MST-MRDT/DCDC-Buck-Converter/README.md

# DCDC-Buck-Converter
Repo for the hardware files for the DC/DC buck converter
