MST-MRDT/DCDC-Buck-Converter/dcdc_converter_sim.asc

C1: polcap; 22µ; V=80 Irms=.115 Rser=.55
C2: polcap; 220µ; V=100 Irms=2.14 Rser=.068
C3: cap; 22p; V=50 Rser=0.02
C4: cap; 1000p; V=100 Rser=.02
CB: cap; .1µ
CC1: cap; 470p; V=50
CC2: cap; 1n; V=50
CC3: cap; 2200p; V=16
CDRVCC: cap; 10µ; V=16
CIN1: polcap; 100µ; V=100 Irms=.647 Rser=.305
COUT: polcap; 220µ; V=100 Irms=2.14 Rser=.068
CSS: cap; .1µ; V=16
CVCC: cap; 1µ
D1: schottky; RB160M-30
DB: diode; RF05VA1S
L1: ind; 3.3µ; Ipk=70 Rser=.0011
LOAD: res; R=V(VRESISTOR)
M1: nmos; PSMN4R060YS
M2: nmos; PSMN4R060YS
R1: res; 113k; tol=1 pwr=.063
R2: res; 8.06k; tol=1 pwr=.063
RC1: res; 10k
RC2: res; 10k
RF: res; 10; tol=1 pwr=.063
RMAX: res; 30k; tol=1 pwr=.063
RSET: res; 12k
TARGET: res; R=V(VRESISTOR)
U1: LTC3703-5
V1: voltage; 12
V2: voltage; PWL file=load_pwl.txt
VCC: voltage; 5
VIN: voltage; 24; Rser=.0048
Named nets: 0, VRESISTOR, VOUT, VTARGET
.tran 0 3m
Sense Line
Battery pack simulation
Load simulation
Step load resistor through values in PWL file
Ideal power supply for comparison
