MST-MRDT/DCDC-Buck-Converter/DC-DC Buck Converter Rev1.brd

## EAGLE design DC-DC Buck Converter Rev1.brd (2018-02-13)

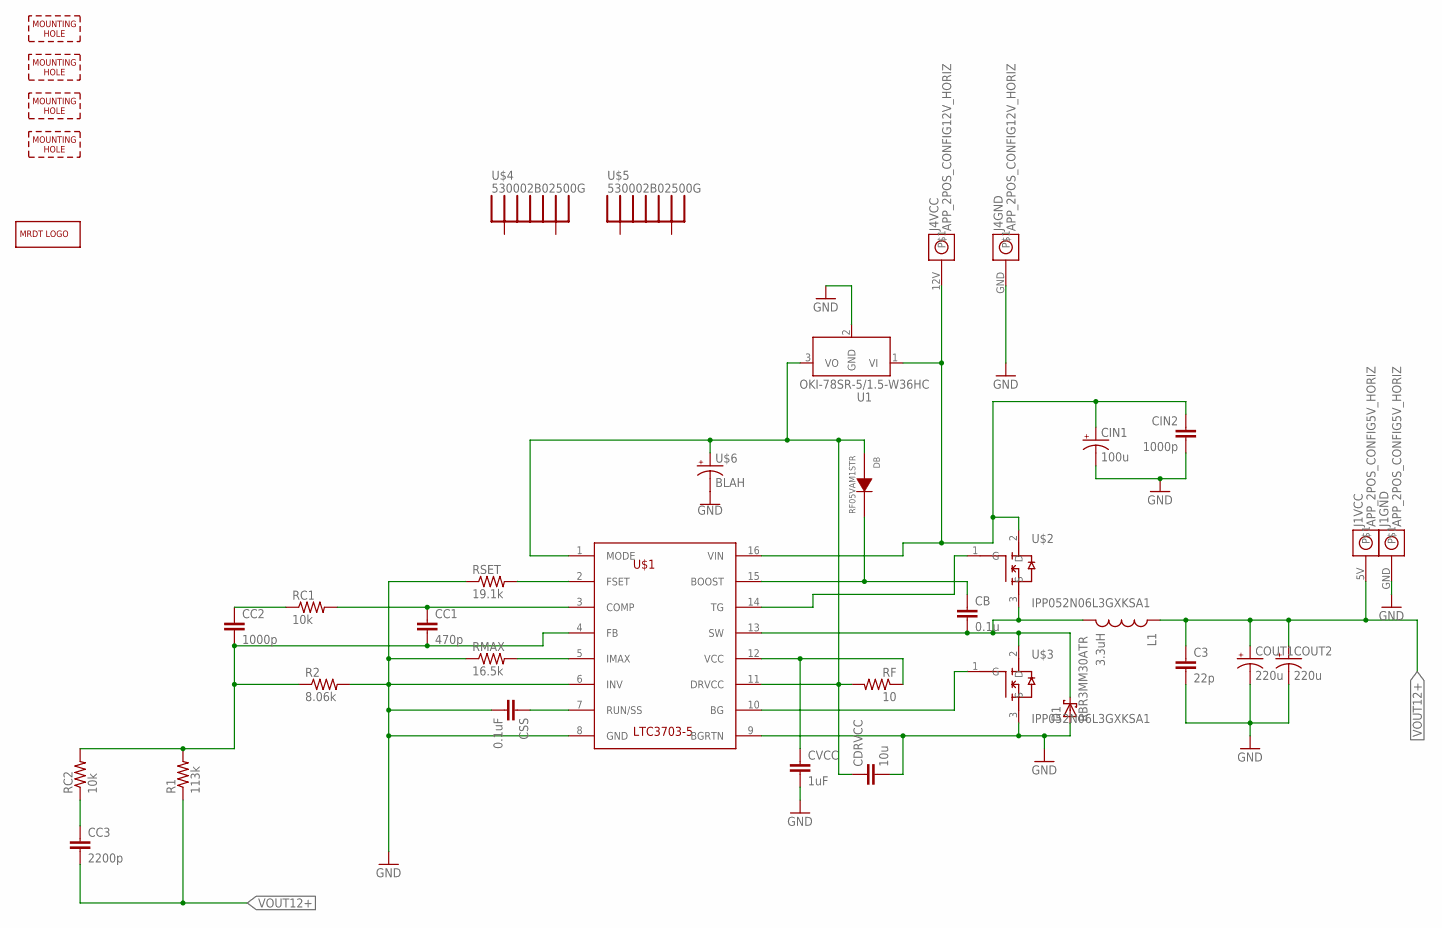
[picture p1: schematic DC-DC Buck Converter Rev1.sch]

Parts:
C3: 22p; 0603-CAP
CB: 0.1u; 0603-CAP
CC1: 470p; 0603-CAP
CC2: 1000p; 0603-CAP
CC3: 2200p; 0603-CAP
CDRVCC: 10u; 0603-CAP
CIN1: 100u; CAP_POL_220UF
CIN2: 1000p; 0603-CAP
COUT1, COUT2: 220u; CAP_POL_220UF
CSS: 0.1uF; 0603-CAP
CVCC: 1uF; 0603-CAP
D1: RBR3MM30ATR; DIODE_SCHOTTKY_30V_1A
DB: RF05VAM1STR; DIODE_STANDARD_100V
H1, H2, H3, H4: MOUNTING_HOLE#8; #8_SCREW
J1: APP_2POS_CONFIG5V_HORIZ; APP45_5V_HORIZ_CONFIG
J4: APP_2POS_CONFIG12V_HORIZ; APP45_12V_HORIZ_CONFIG
L1: 3.3uH; PLANAR_INDUCTOR_3.3UH
LOGO1: MRDT_LOGO
R1: 113k; 0603-RES
R2: 8.06k; 0603-RES
RC1, RC2: 10k; 0603-RES
RF: 10; 0603-RES
RMAX: 16.5k; 0603-RES
RSET: 19.1k; 0603-RES
U1: OKI-78SR-5/1.5-W36HC; OKI-78SR_HORIZ
U$1: LTC3703-5; SSOP-16
U$2, U$3: IPP052N06L3GXKSA1; TO-220
U$4, U$5: 530002B02500G; RADIAL_FIN_HEATSINK
U$6: BLAH

Connections:
5V: CDRVCC.1, DB.P$2 (A), RF.2, U1.3 (VO), U$1.1 (MODE), U$1.11 (DRVCC), U$6.P$2 (+)
GND: C3.2, CDRVCC.2, CIN1.GND (-), CIN2.2, COUT1.GND (-), COUT2.GND (-), CSS.2, CVCC.2, D1.P$1 (A), J1.GND, J4.GND, R2.2, RMAX.1, RSET.1, U1.2 (GND), U$1.6 (INV), U$1.8 (GND), U$1.9 (BGRTN), U$3.3 (S), U$6.P$1 (-)
unnamed: CB.1, DB.P$1 (K), U$1.15 (BOOST)
unnamed: U$1.14 (TG), U$2.1 (G)
unnamed: RSET.2, U$1.2 (FSET)
unnamed: RMAX.2, U$1.5 (IMAX)
unnamed: CSS.1, U$1.7 (RUN/SS)
unnamed: CC1.1, RC1.2, U$1.3 (COMP)
unnamed: CC2.1, RC1.1
unnamed: CC3.1, RC2.1
unnamed: CC1.2, CC2.2, R1.2, R2.1, RC2.2, U$1.4 (FB)
unnamed: CVCC.1, RF.1, U$1.12 (VCC)
unnamed: U$1.10 (BG), U$3.1 (G)
unnamed: CB.2, D1.P$2 (C), L1.P$2 (2), U$1.13 (SW), U$2.3 (S), U$3.2 (D)
VBATT: CIN1.+, CIN2.1, J4.12V, U1.1 (VI), U$1.16 (VIN), U$2.2 (D)
VOUT12+: C3.1, CC3.2, COUT1.+, COUT2.+, J1.5V, L1.P$1 (1), R1.1

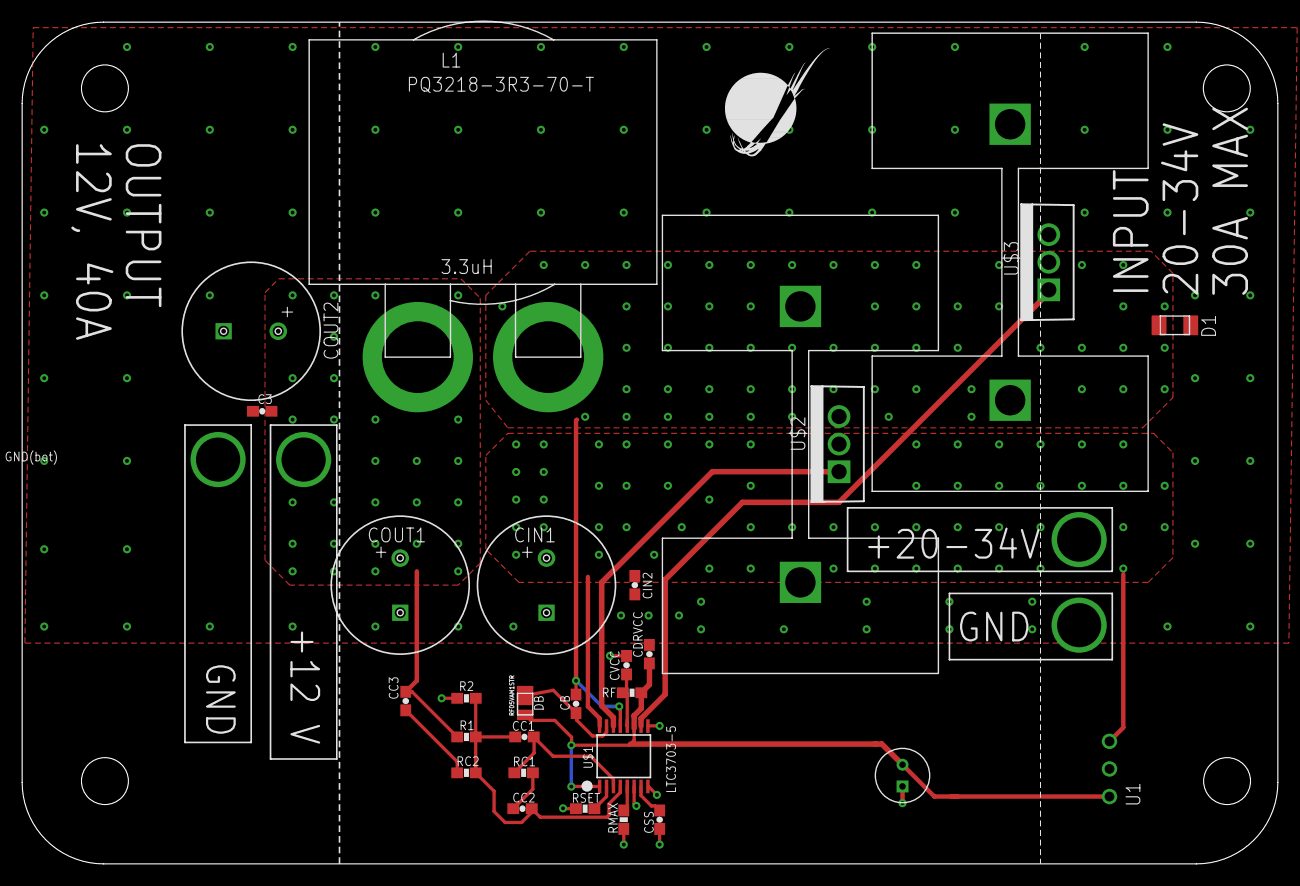
[picture p2: board DC-DC Buck Converter Rev1.brd from above]

Board: 2 copper layers, 115.6 x 77.5 mm, 36 parts (0 on the bottom side), 16 nets.
