MST-MRDT/DCDC-Buck-Converter/(commit log)

2017-10-12 Initial Schematic
    Need to replace dummy components with real components with actual footprint
    [SwitchingRegulator.sch]
2017-10-14 Updated a few components
    COUT 1, COUT 2, CIN1, and C1 now correspond to their true package
    [SwitchingRegulator.sch]
2017-10-14 Updated with all real components
    Added devices for inductor, diodes, and mosfets
    [SwitchingRegulator.brd, SwitchingRegulator.sch]
2017-10-14 Board design initiated
    [SwitchingRegulator.brd, SwitchingRegulator.sch]
2017-10-15 Revision 1 routing complete
    LTC3703-5 datasheet provided a list of constraints that had to be worked around. Ground plane separated into a signal ground and a power ground. Some components needed to be placed close to the IC as well causing some suboptimal routes.
    [SwitchingRegulator.brd, SwitchingRegulator.sch]
2017-10-15 Major rearrangements
    [SwitchingRegulator.brd, SwitchingRegulator.sch]
2017-10-16 Reconfigured board, still doesn't support 40A
    [SwitchingRegulator.brd]
2017-10-23 New layout, do power power path
    [SwitchingRegulator.brd, SwitchingRegulator.sch]
2017-10-24 Routing completed, needs to be approved
    Added complete via stitching around all power traces. Signal ground in lower right joined to power ground close to negative output terminal. Sloppy routing under LTC chip, could be cleaner probably
    [SwitchingRegulator.brd]
2017-10-25 Major revision, moved LTC to bottom
    Changed signal traces to be much closer to LTC chip. Modified via stitching to cover whole polygon rather than edges only. No more vias under IC. Moved inductor to top side of board to prevent LTC from heating up due to MOSFET heat. Added silkscreen stuff. More fine details to come
    [SwitchingRegulator.brd, SwitchingRegulator.sch]
2017-10-26 Finishing touches
    Finished via stitching, added labels and logo, adjusted mounting holes
    [SwitchingRegulator.brd]
2017-10-28 Switched to upright mosfets, adjusted board accordingly
    Spread out some of the signal components on the bottom side of the board. Adjusted power planes to compensate for new mosfet orientation.
    [SwitchingRegulator.brd, SwitchingRegulator.sch]
2017-10-29 Improved silkscreen labeling
    Moved labeling to tplace layer because tsilk layer does not pront in manufacturing. Elarged labels on each resistor and capacitor to help in populating the board.
    [SwitchingRegulator.brd]
2017-10-30 Heatsinks added, rearranges needed
    [SwitchingRegulator.brd, SwitchingRegulator.sch]
2017-10-30 Power traces turned horizontal
    [SwitchingRegulator.brd]
2017-11-02 Final revision for testing
    Finished via stitching
    [SwitchingRegulator.brd]
2017-11-02 Rev1 Gerb Files and Folder Cleanup
    Changed names of files from switching regulator to DC-DC Buck Converter. Zipped folder containing the Gerb files for ordering Rev1 added. Added gitignore that will hopefully work since some unwanted files are still visible. Changed text on board to vector font since it would be converted by EasyEDA and look sloppy.
    [DC-DC Buck Converter Rev1.brd, DC-DC Buck Converter Rev1.sch]
2017-12-03 Add Simulation
    [PWL_Calculation.csv]
2018-02-13 Small changes
    Replaced Oki capacitor, moved diode, deleted output anderson
    [DC-DC Buck Converter Rev1.brd, DC-DC Buck Converter Rev1.sch]
